berendvosmer/Tekenrobot/Hardware/Fotos/Small_Hardware_Parts.jpg

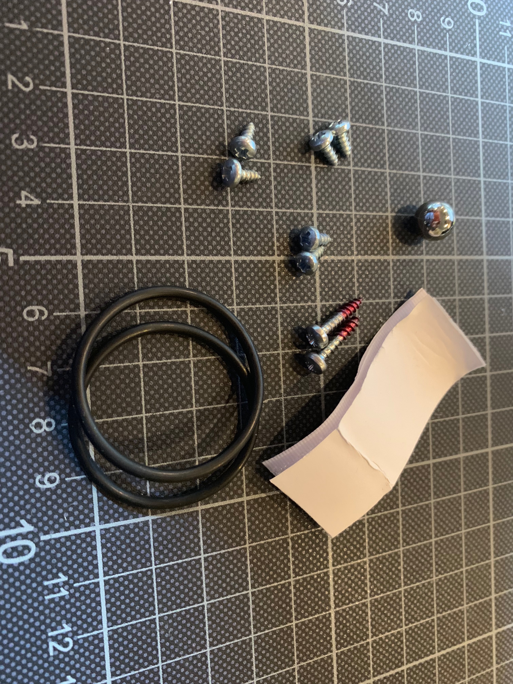
Hardware/Fotos/Small_Hardware_Parts.jpg
