berendvosmer/Tekenrobot/Documentation/Images/Arduino Create/Arduino Create.png

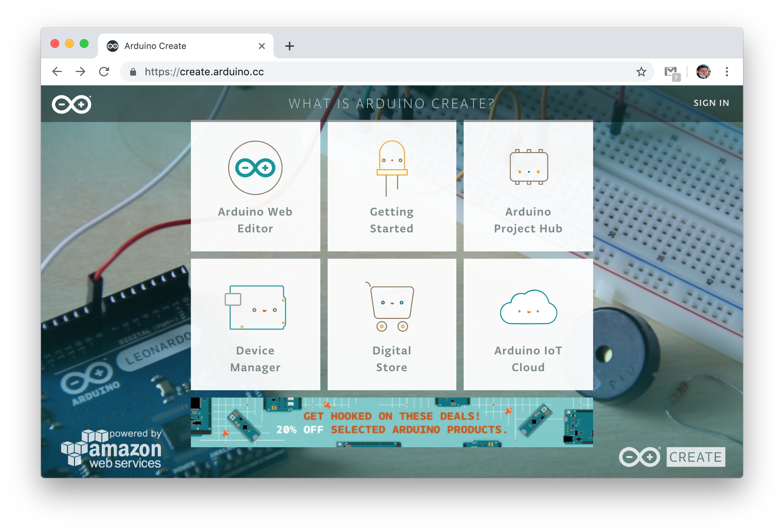
Documentation/Images/Arduino Create/Arduino Create.png
