berendvosmer/Tekenrobot/Documentation/Images/Arduino Create/Arduino Web Editor Error.png

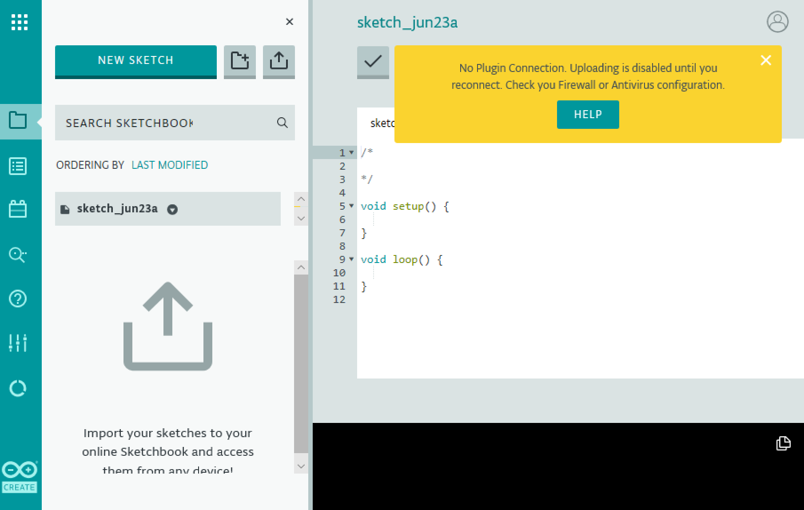
Documentation/Images/Arduino Create/Arduino Web Editor Error.png
