berendvosmer/Tekenrobot/Documentation/Images/Arduino Create/Choose port and board.png

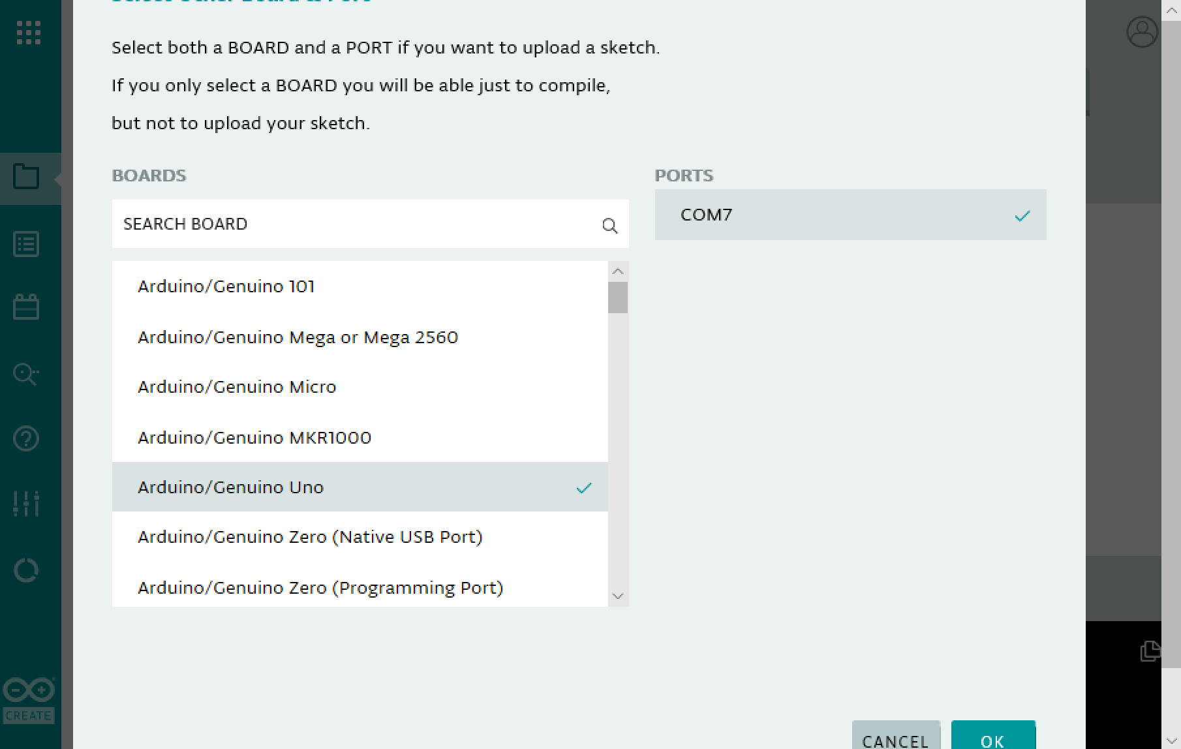
Documentation/Images/Arduino Create/Choose port and board.png
