berendvosmer/Tekenrobot/Documentation/Images/Arduino Create/Download Plug-in.png

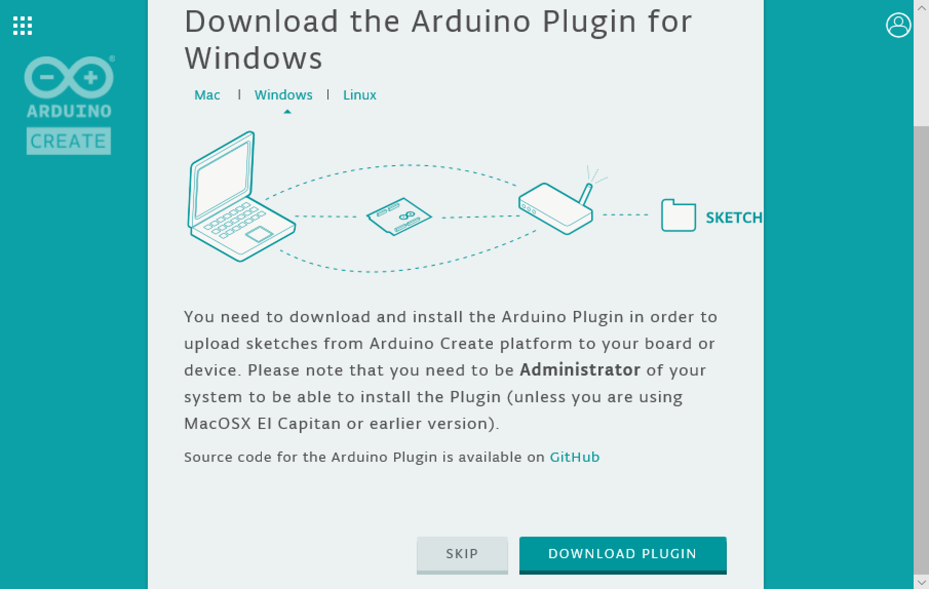
Documentation/Images/Arduino Create/Download Plug-in.png
