berendvosmer/Tekenrobot/Documentation/Images/Arduino Create/Succes.png

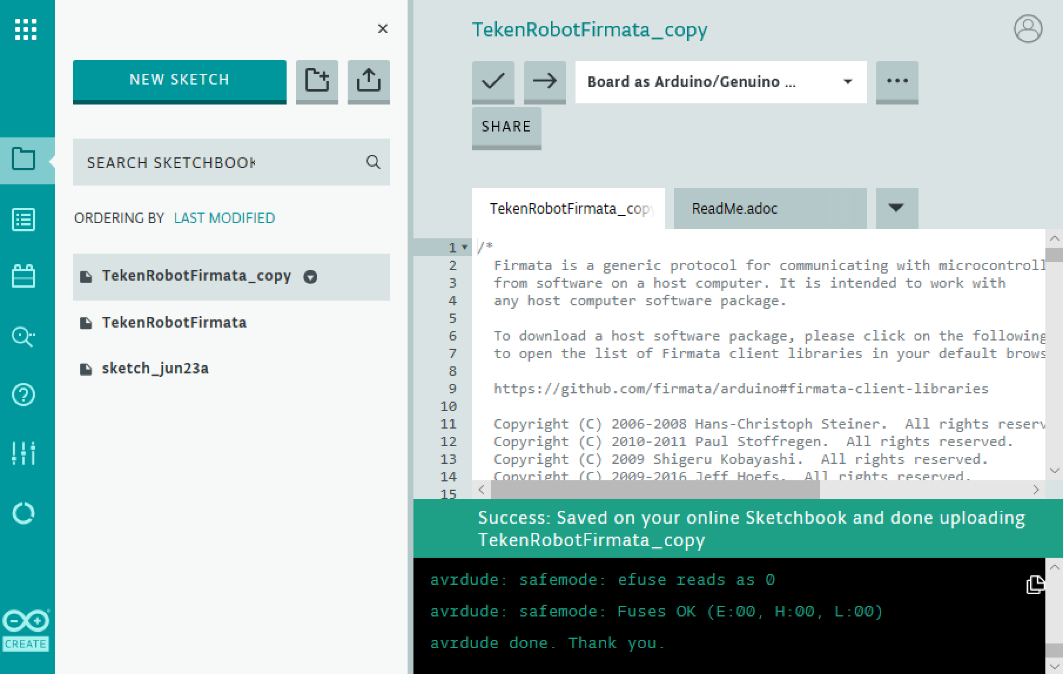
Documentation/Images/Arduino Create/Succes.png
