berendvosmer/Tekenrobot/Documentation/Images/Disconnect Bluetooth module.jpg

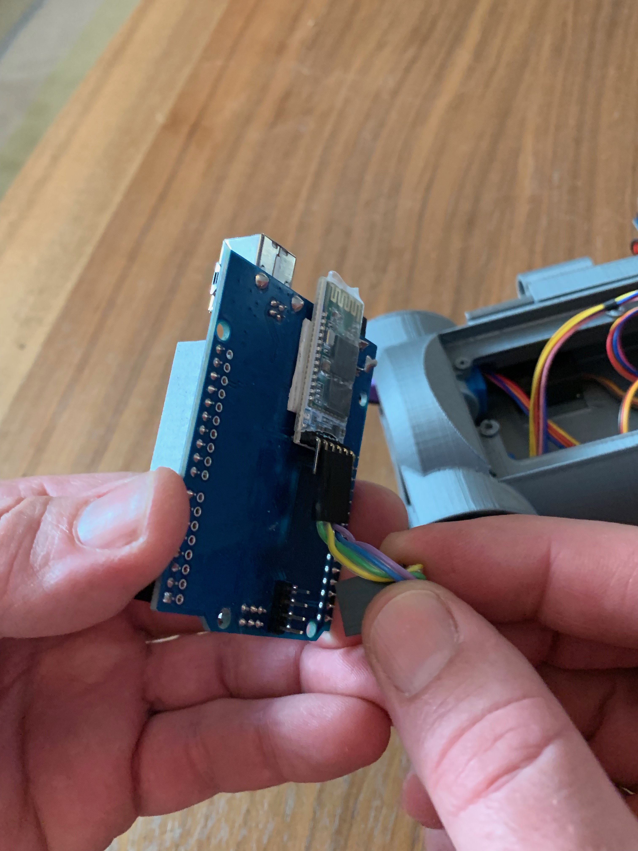
Documentation/Images/Disconnect Bluetooth module.jpg
