berendvosmer/Tekenrobot/Documentation/Images/Fold away motor shield.jpg

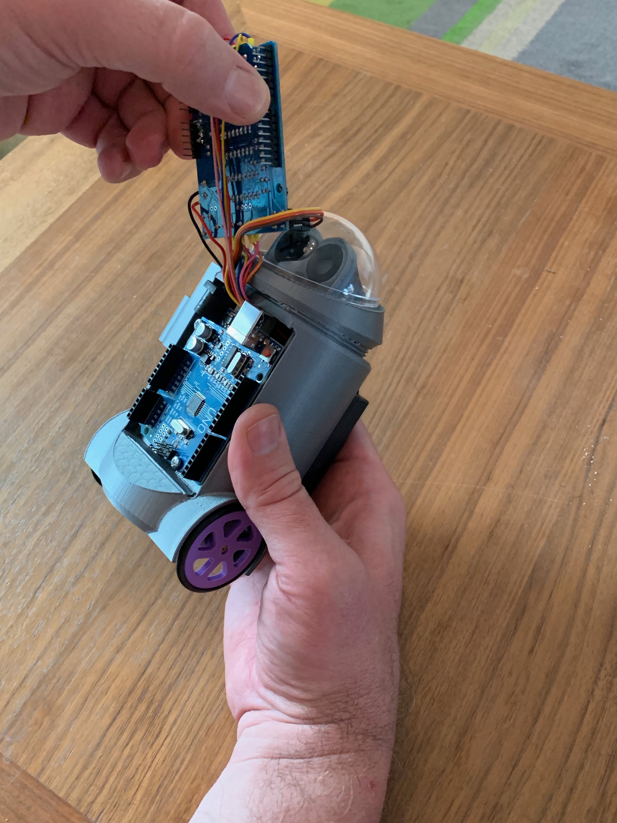
Documentation/Images/Fold away motor shield.jpg
