berendvosmer/Tekenrobot/Documentation/Images/IMG_0233.jpg

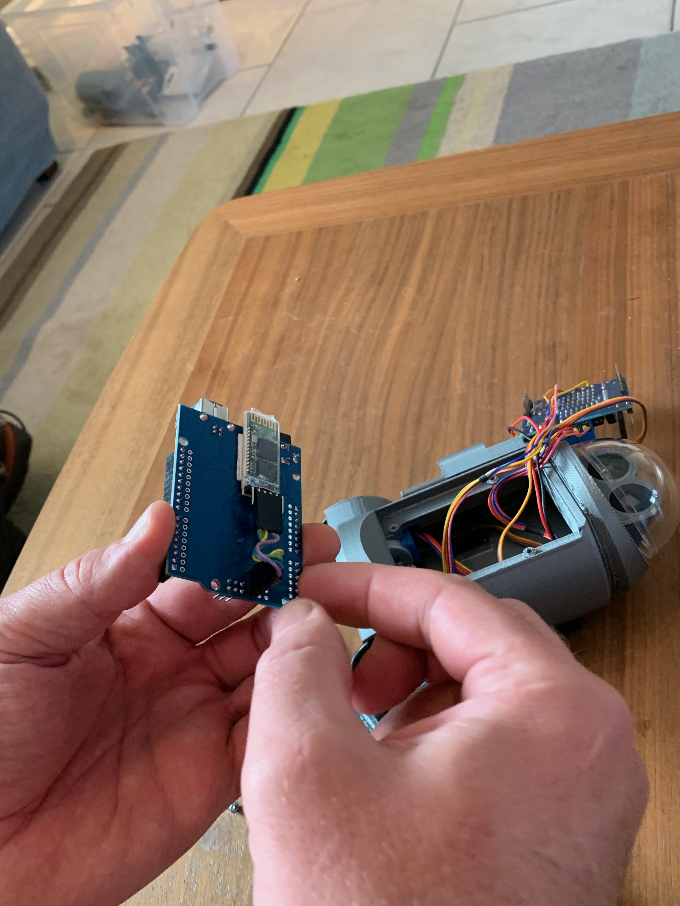
Documentation/Images/IMG_0233.jpg
