berendvosmer/Tekenrobot/Documentation/Images/IMG_0234.jpg

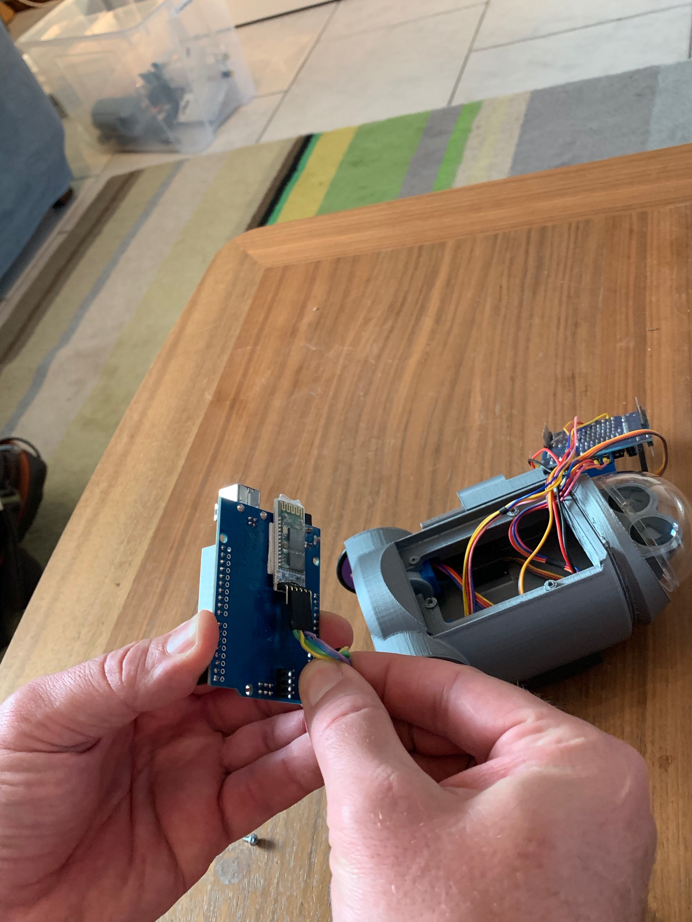
Documentation/Images/IMG_0234.jpg
