berendvosmer/Tekenrobot/Documentation/Images/IMG_0236.jpg

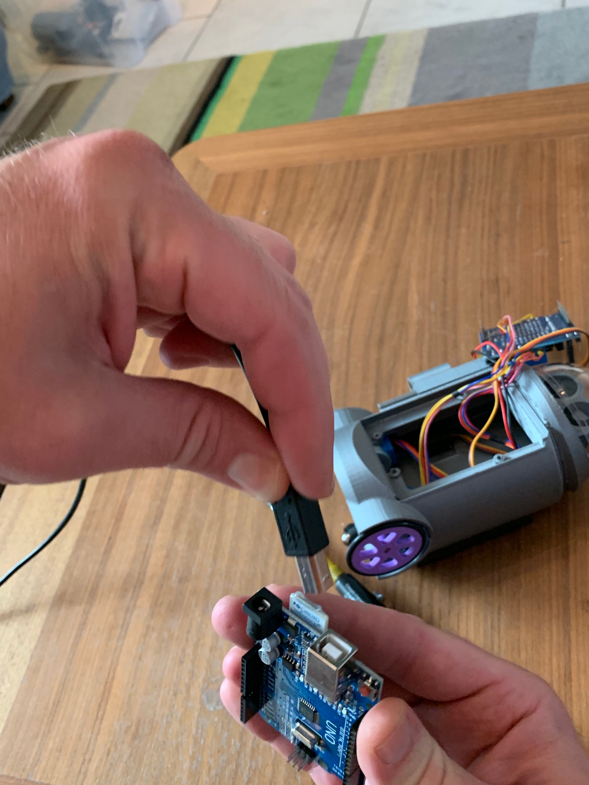
Documentation/Images/IMG_0236.jpg
