berendvosmer/Tekenrobot/Documentation/Images/IMG_0238.jpg

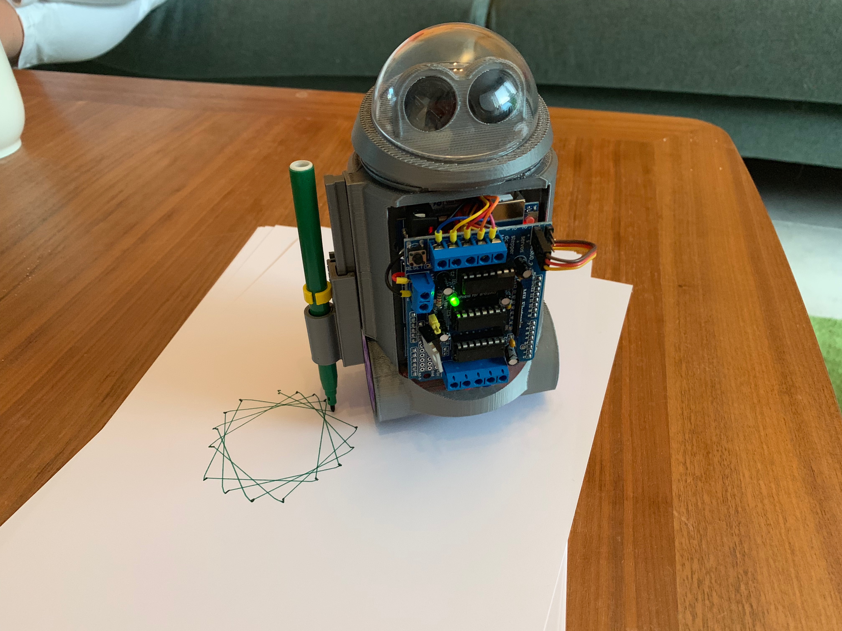
Documentation/Images/IMG_0238.jpg
