berendvosmer/Tekenrobot/Documentation/Images/Plug in USB cable.jpg

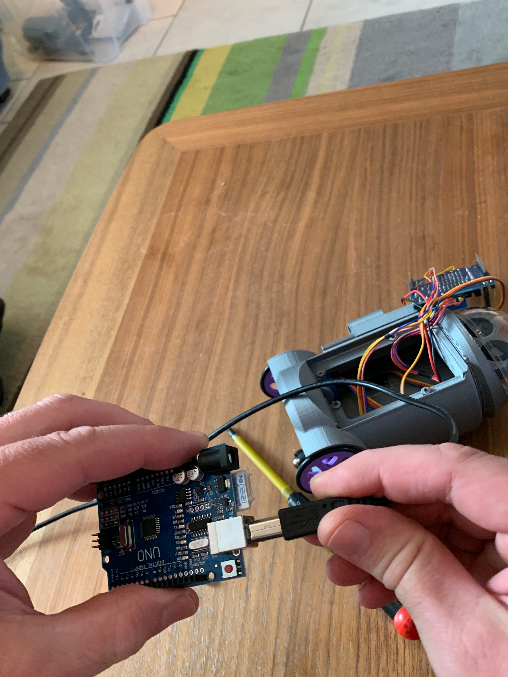
Documentation/Images/Plug in USB cable.jpg
