berendvosmer/Tekenrobot/Documentation/Images/Remove Arduino.jpg

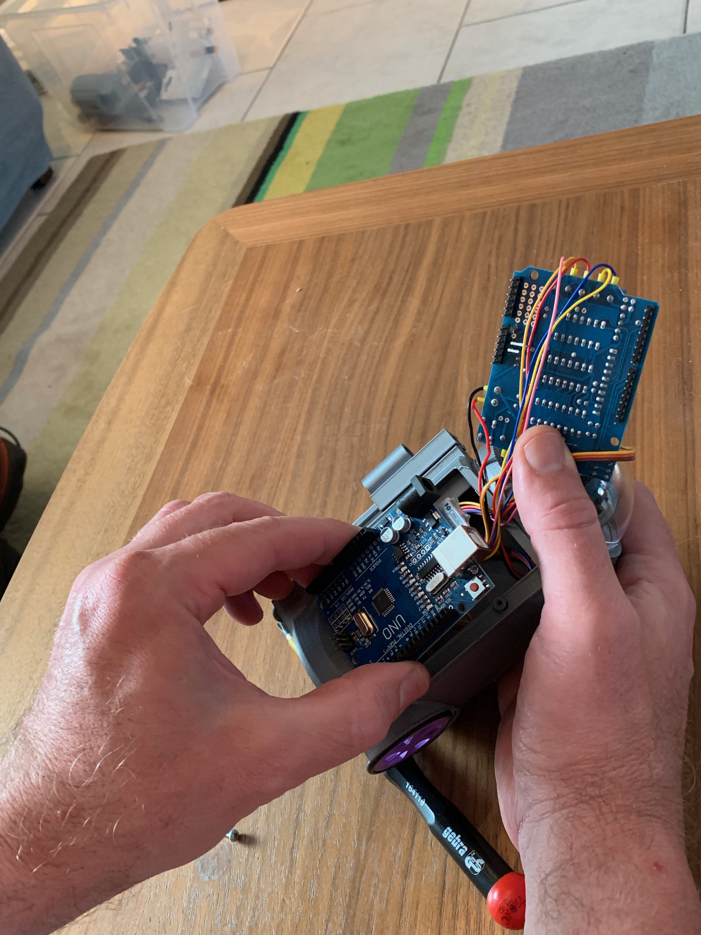
Documentation/Images/Remove Arduino.jpg
