berendvosmer/Tekenrobot/Documentation/Images/Remove Motor Shield.jpg

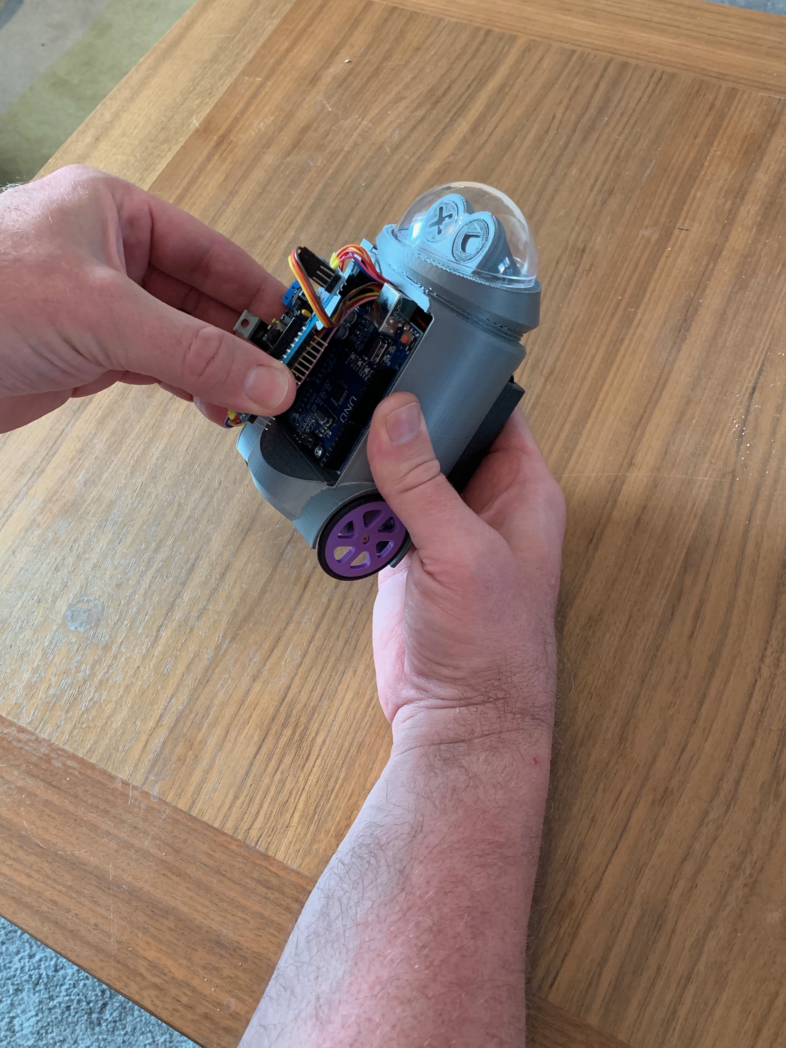
Documentation/Images/Remove Motor Shield.jpg
