berendvosmer/Tekenrobot/Documentation/Images/Snap4Arduino/Bluetooth prefs.png

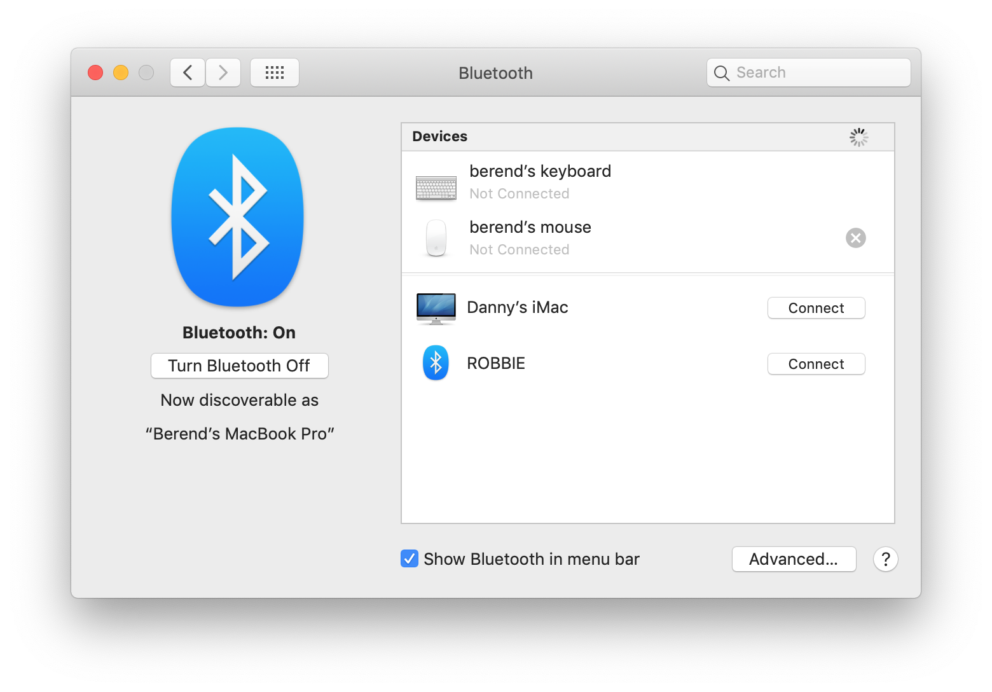
Documentation/Images/Snap4Arduino/Bluetooth prefs.png
