berendvosmer/Tekenrobot/Documentation/Images/Snap4Arduino/select port.png

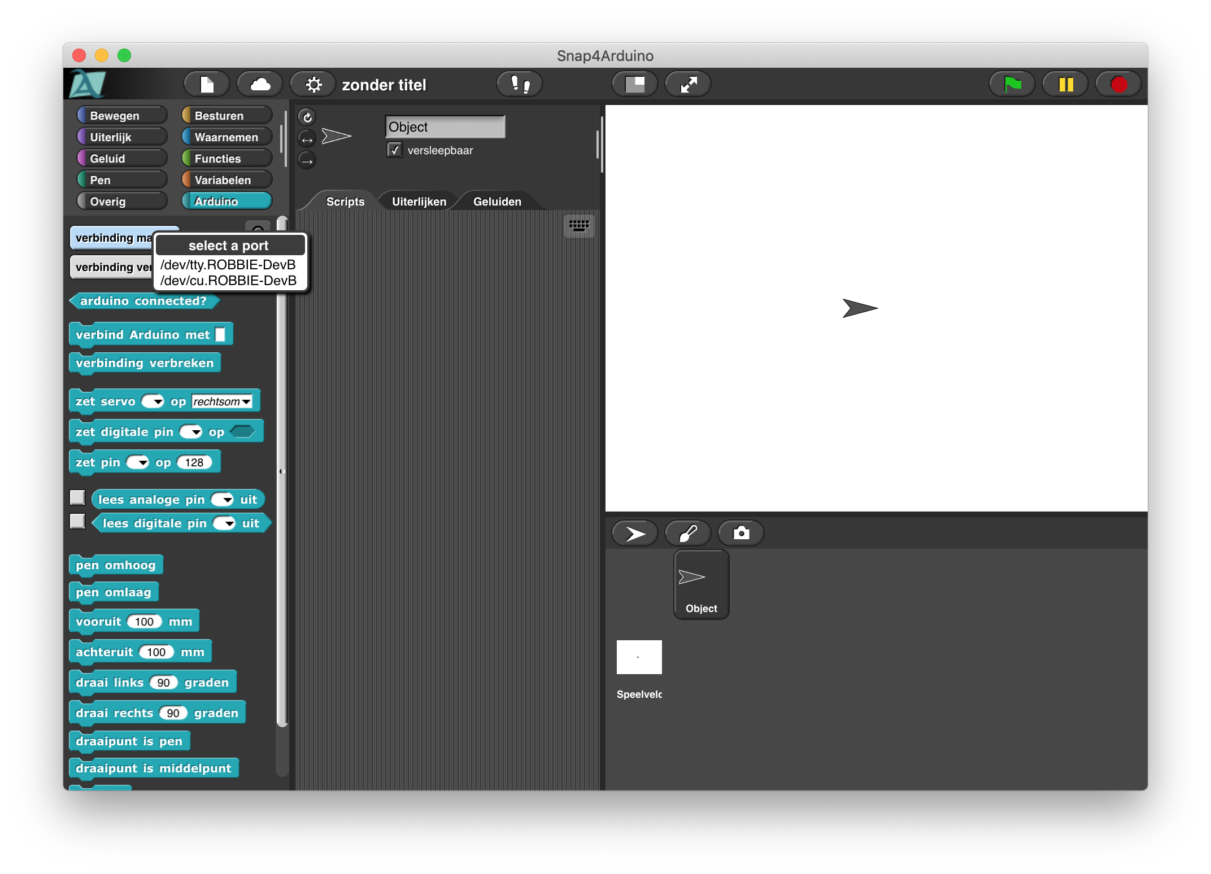
Documentation/Images/Snap4Arduino/select port.png
