berendvosmer/Tekenrobot/Documentation/Images/Unscrew Arduino 1.jpg

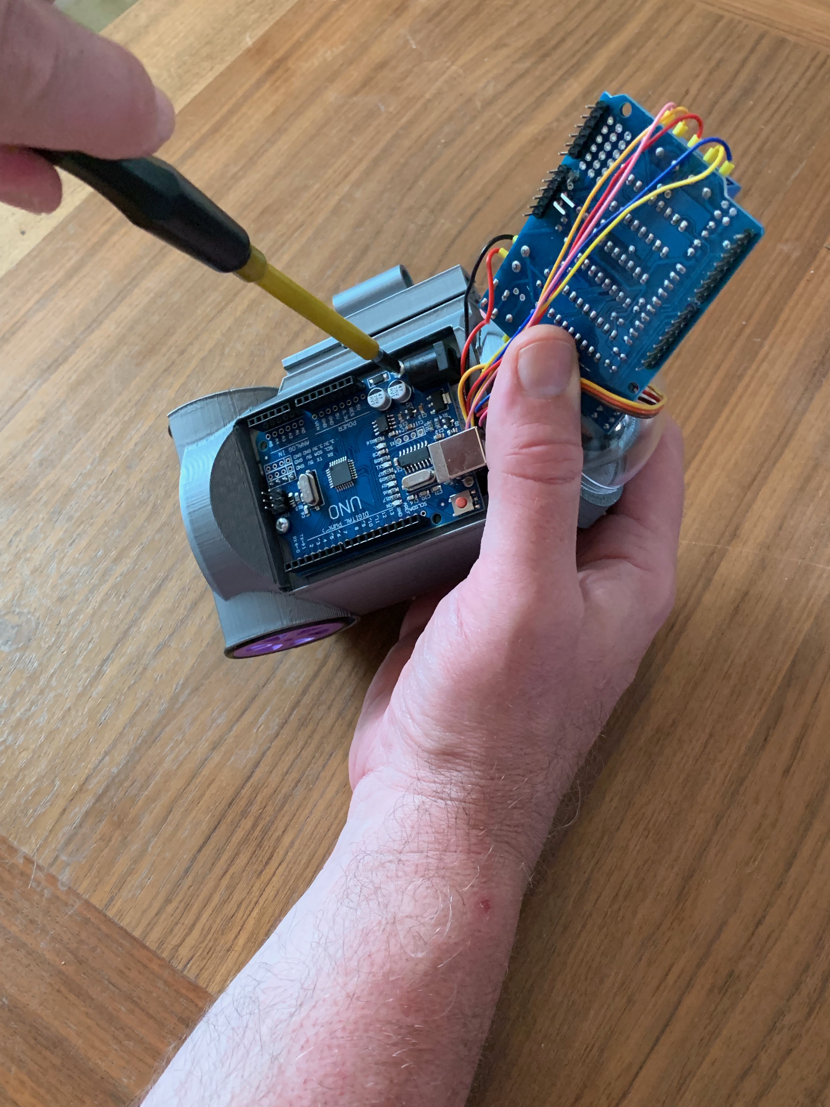
Documentation/Images/Unscrew Arduino 1.jpg
