berendvosmer/Tekenrobot/Documentation/Images/Unscrew Arduino 2.jpg

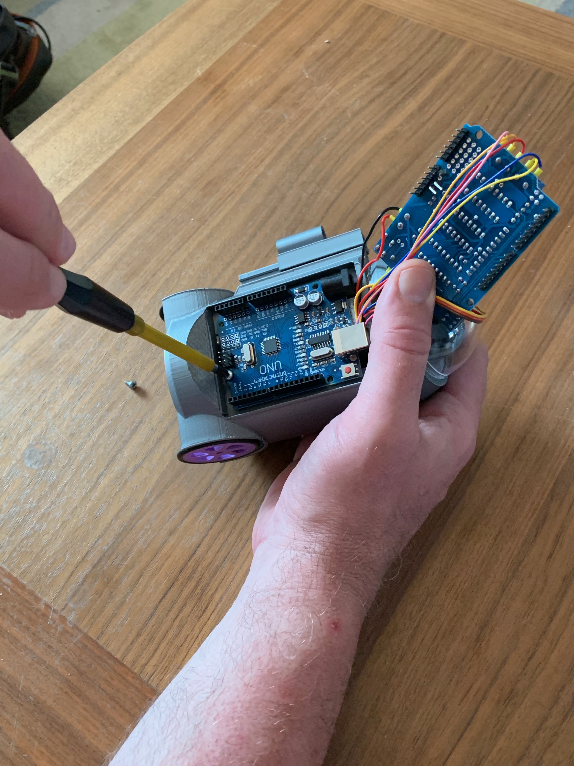
Documentation/Images/Unscrew Arduino 2.jpg
