berendvosmer/Tekenrobot/Hardware/Fotos/28BYJ-48_Stepper.jpg

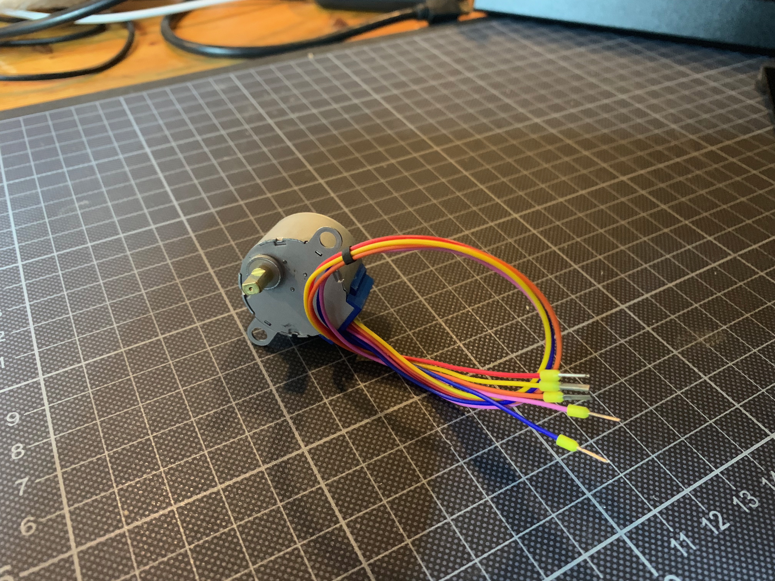
Hardware/Fotos/28BYJ-48_Stepper.jpg
