berendvosmer/Tekenrobot/Hardware/Fotos/Body.jpg

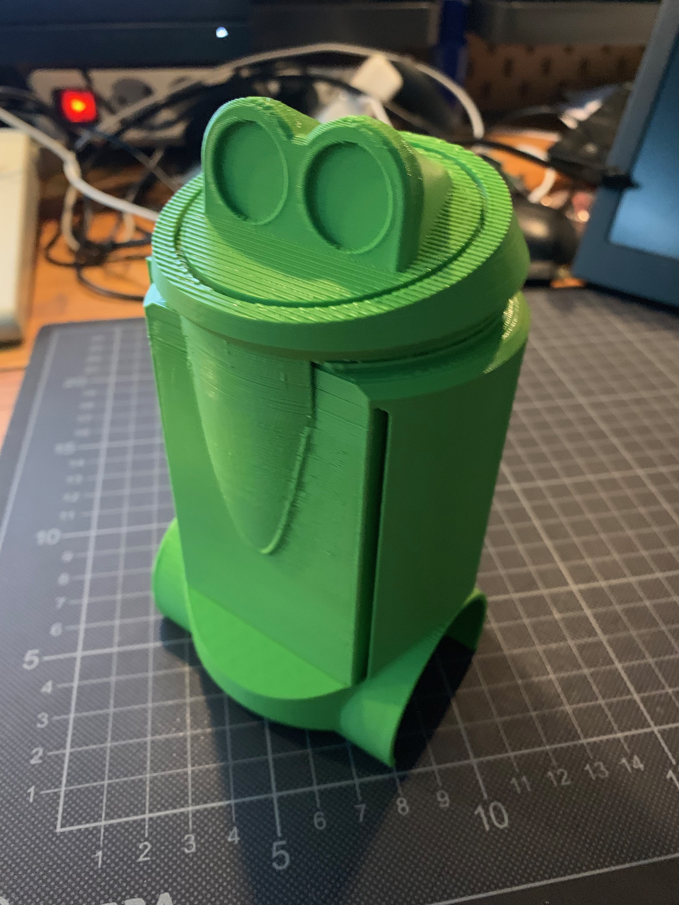
Hardware/Fotos/Body.jpg
