berendvosmer/Tekenrobot/Hardware/Fotos/Casterball_Cage.jpg

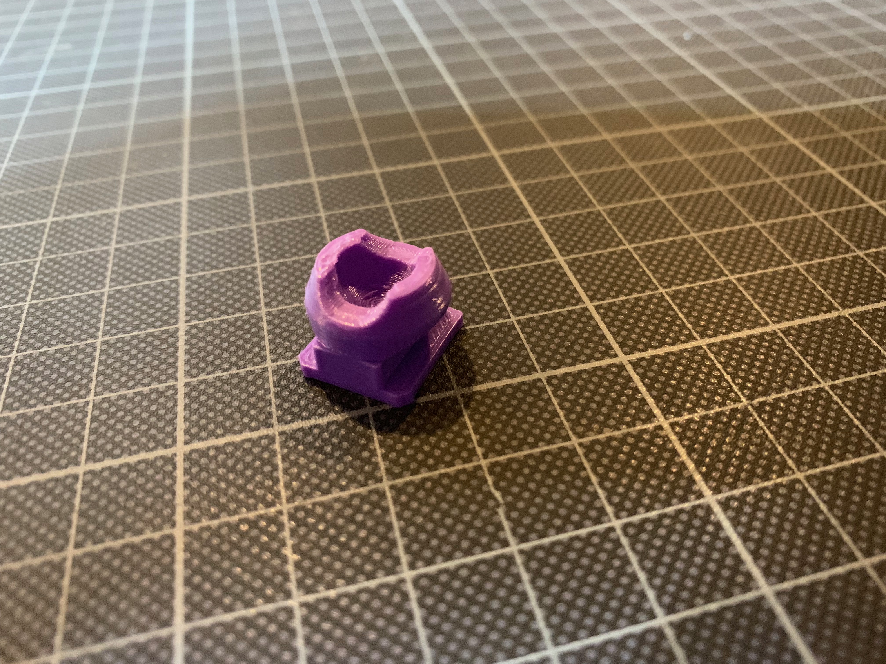
Hardware/Fotos/Casterball_Cage.jpg
