berendvosmer/Tekenrobot/Hardware/Fotos/Dome.jpg

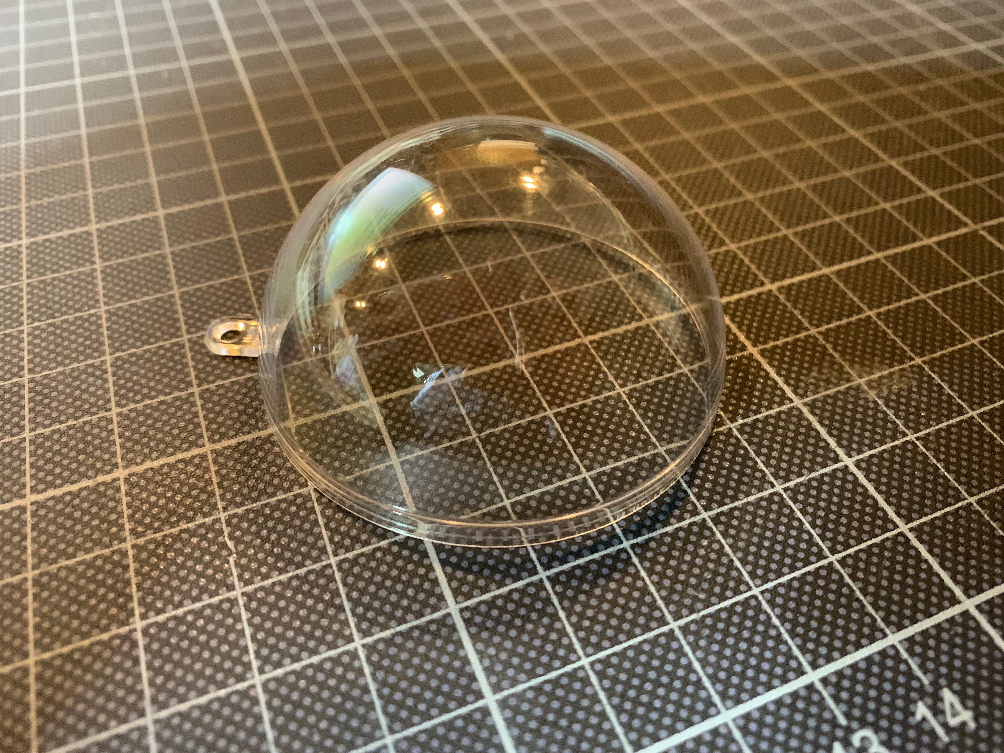
Hardware/Fotos/Dome.jpg
