berendvosmer/Tekenrobot/Hardware/Fotos/Eyes.jpg

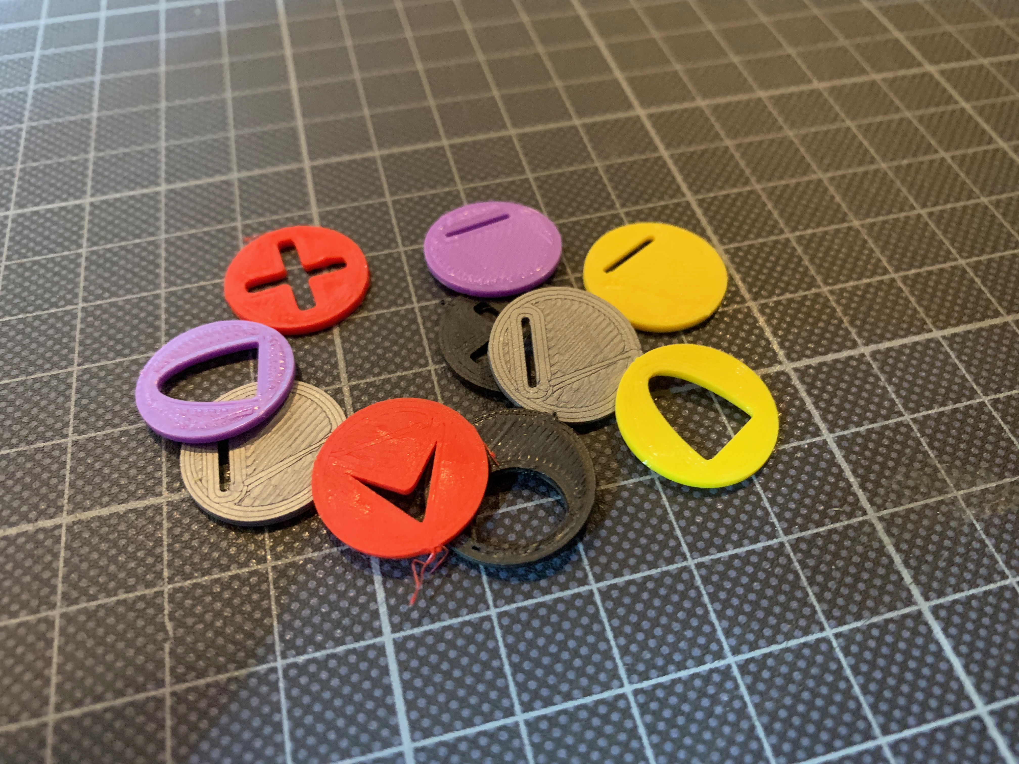
Hardware/Fotos/Eyes.jpg
