berendvosmer/Tekenrobot/Hardware/Fotos/Felt_pen.jpg

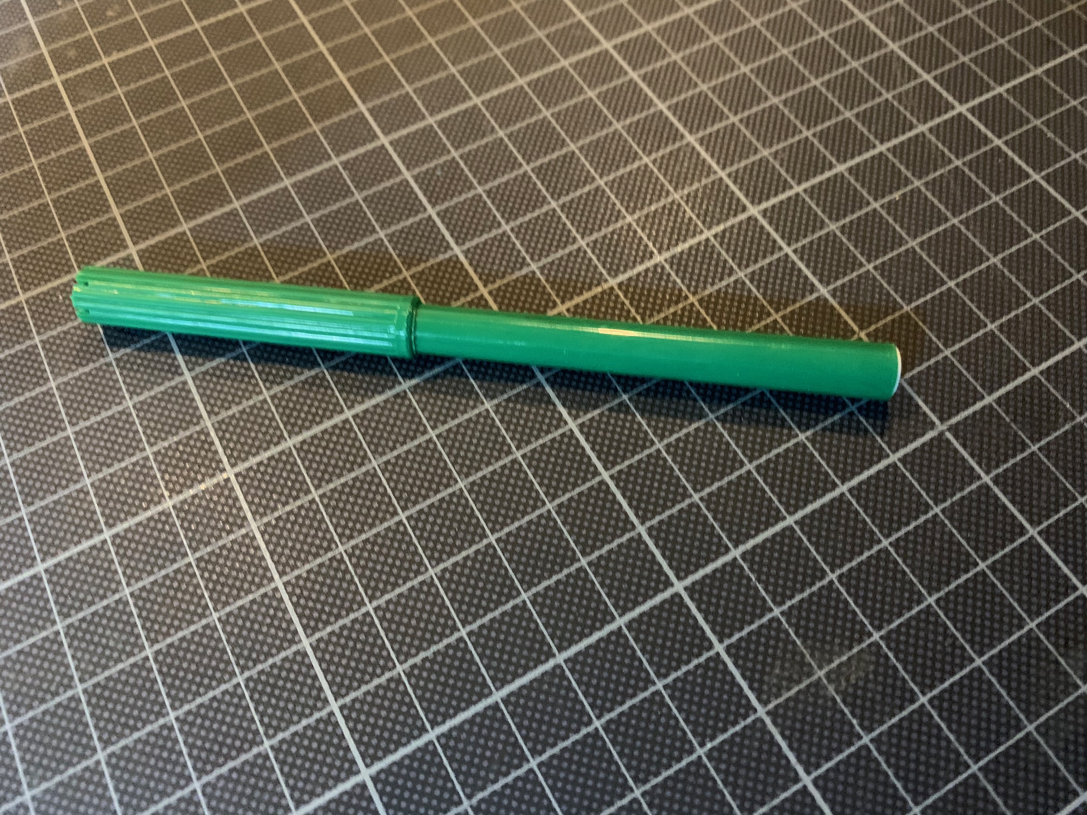
Hardware/Fotos/Felt_pen.jpg
