berendvosmer/Tekenrobot/Hardware/Fotos/Jumper_Wire.jpg

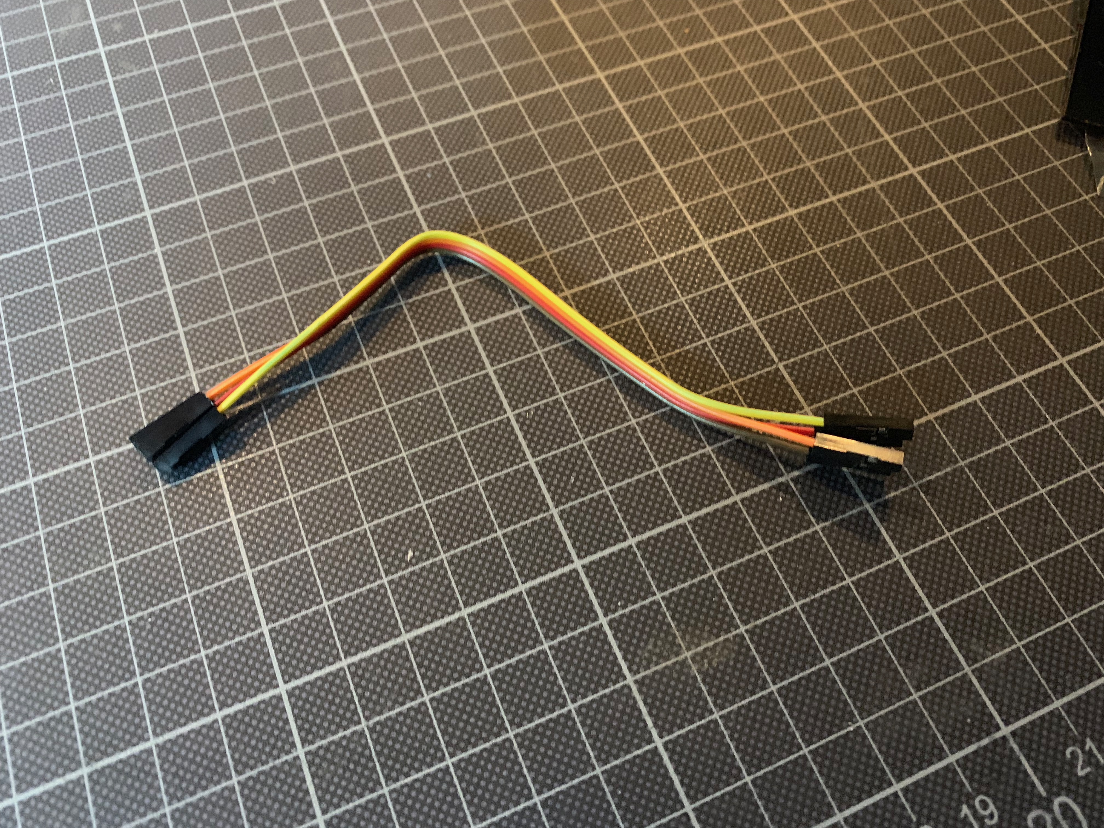
Hardware/Fotos/Jumper_Wire.jpg
