berendvosmer/Tekenrobot/Hardware/Fotos/Pinion_gear.jpg

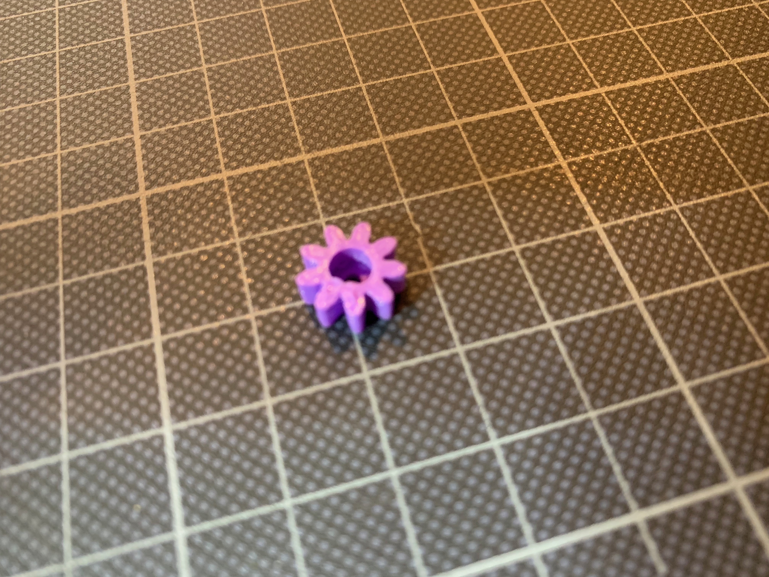
Hardware/Fotos/Pinion_gear.jpg
