berendvosmer/Tekenrobot/Hardware/Fotos/Ring.jpg

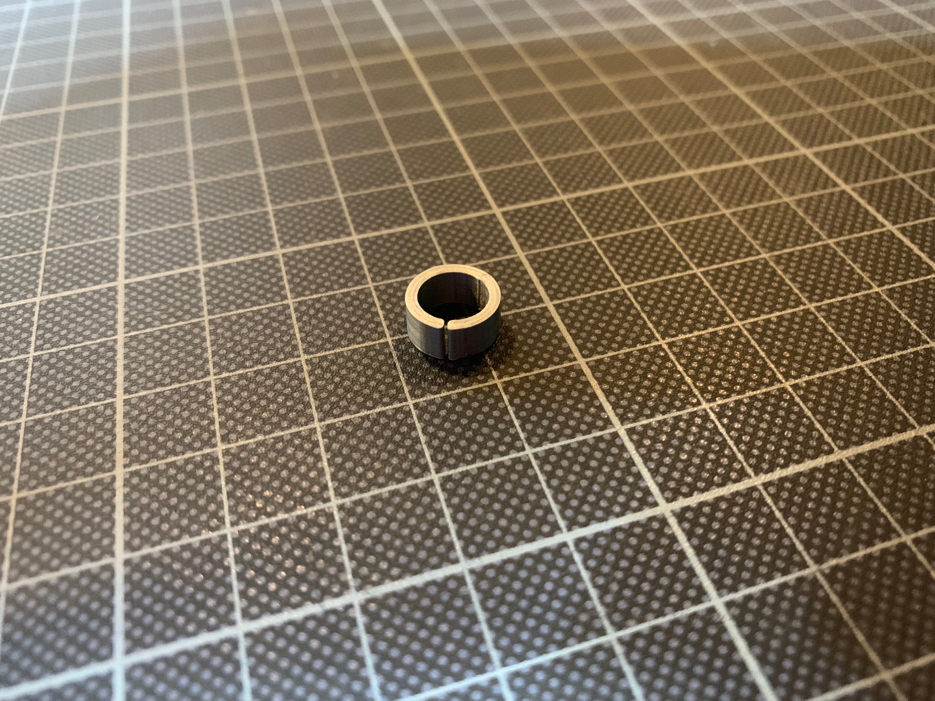
Hardware/Fotos/Ring.jpg
