berendvosmer/Tekenrobot/Hardware/Fotos/Servo_9g.jpg

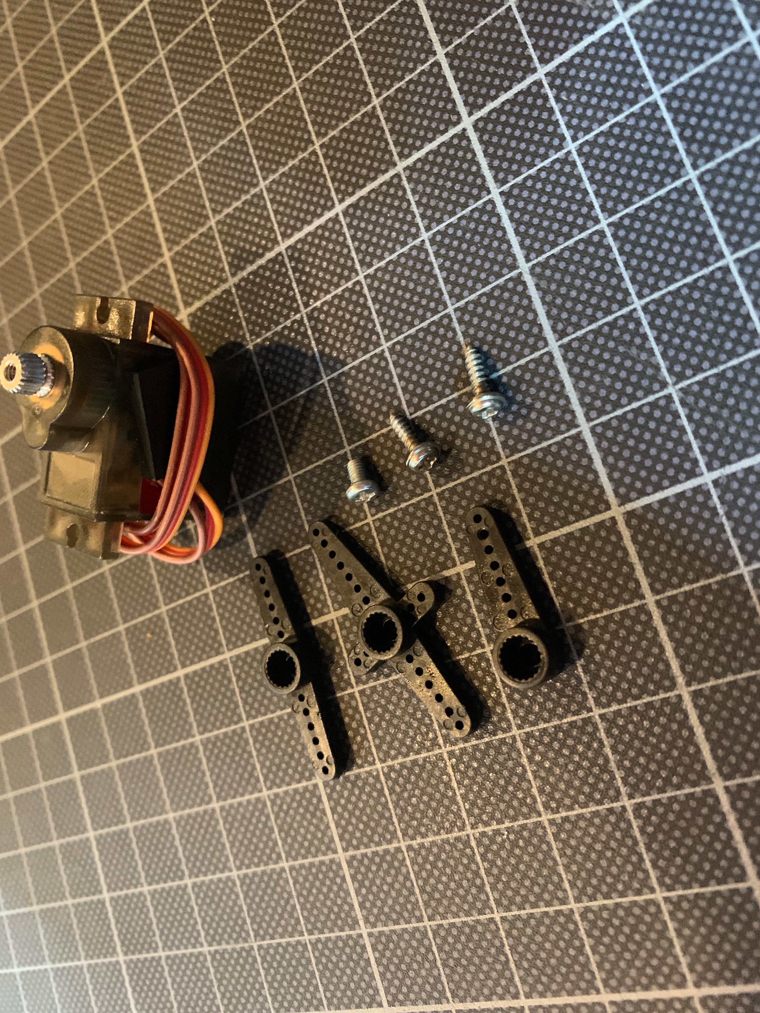
Hardware/Fotos/Servo_9g.jpg
