berendvosmer/Tekenrobot/Hardware/Fotos/Velcro.jpg

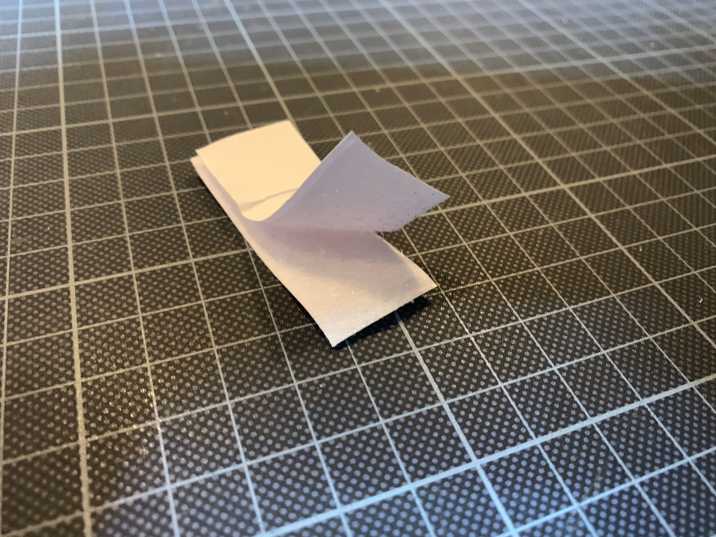
Hardware/Fotos/Velcro.jpg
