berendvosmer/Tekenrobot/Hardware/Fotos/Wheels.jpg

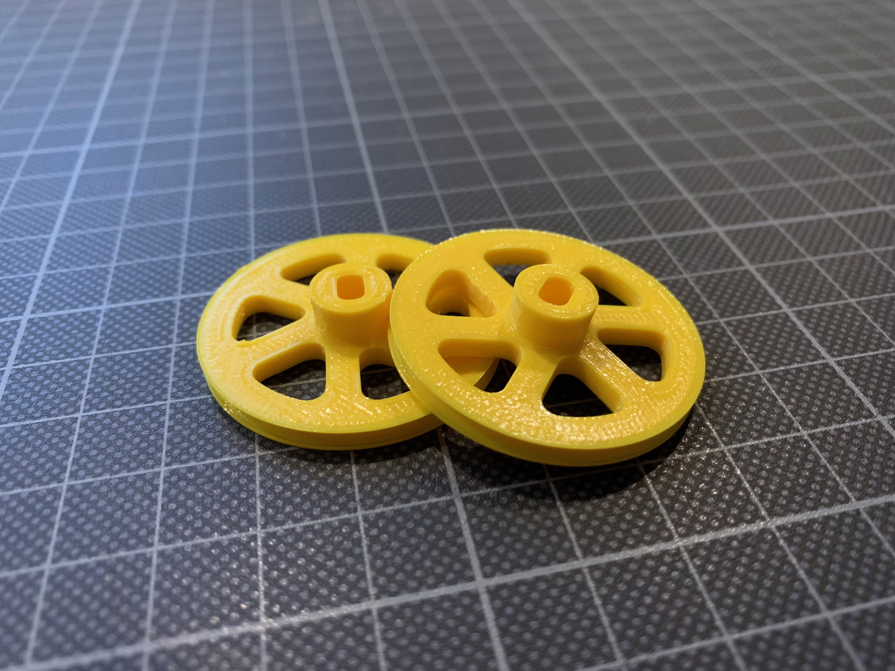
Hardware/Fotos/Wheels.jpg
