berendvosmer/Tekenrobot/Hardware/Bill of Materials.xlsx

Part # | Description | Qty | Est. Cost per item | Est. Cost | Where I got it
1 | Robot body | 1 | €4.43 | €4.43 | Printed part
2 | Right Wheel | 1 | €0.09 | €0.09 | Printed part
3 | Left Wheel | 1 | €0.09 | €0.09 | Printed part
4 | Guiderail | 1 | €0.11 | €0.11 | Printed part
5 | Guide | 1 | €0.21 | €0.21 | Printed part
6 | Ring | 1 | €0.01 | €0.01 | Printed part
7 | Casterball Cage | 1 | €0.07 | €0.07 | Printed part
8 | Pinion Gear | 1 | €0.01 | €0.01 | Printed part
9 | Eyes | 2 | €0.02 | €0.04 | Printed part
10 | Dome (half of transparent decorative ball) 60mm | 1 | €0.50 | €0.50 | any hobby shop
11 | Felt pen (9mm diam.) | 1 | €0.05 | €0.05 | hema.nl
12 | Piece of stick-on Velcro (both sides) | 1 | €0.10 | €0.10 | DIY shop
13 | 28BYJ-48 5v Stepper motor | 2 | €1.22 | €2.44 | AliExpress
14 | 4-lead female-female jumper wire | 1 | €0.02 | €0.02 | AliExpress
15 | Hobby servo metal-gear 9g | 1 | €1.77 | €1.77 | AliExpress
16 | Arduino Uno (with serial breakout) | 1 | €2.12 | €2.12 | AliExpress
17 | Adafruit AF_Motor v1 shield | 1 | €0.95 | €0.95 | AliExpress
18 | Bluetooth module (HC-05 or JDY-30) | 1 | €1.40 | €1.40 | AliExpress
19 | O-ring 3.1mm x 37mm | 2 | €0.12 | €0.24 | AliExpress
20 | raised head philips screw 2.9mm x 6.5 mm | 6 | €0.07 | €0.42 | Local electronics store
21 | raised head philips screw 2.9mm x 16 mm | 2 | €0.07 | €0.14 | Local electronics store
22 | Bearing Ball 9mm | 1 | €0.07 | €0.07 | AliExpress
23 | Battery holder 4x AA with switch | 1 | €0.24 | €0.24 | AliExpress
24 | AA Alkaline Battery | 4 | €0.50 | €2.00 | AliExpress
25 | Voltage regulator ultra-low drop TS2940 | 1 | €1.15 | €1.15 | Local electronics store
26 | pin strip, straight 4x1 pin | 1 | €0.00 | €0.00 | included with Arduino
27 | Ferrule 0.25mm2 x 6mm (isolated) | 12 | €0.04 | €0.48 | Local electronics store
 |  |  | Total | €19.15
