berendvosmer/Tekenrobot/Hardware/STLs/Eyes/cross.stl

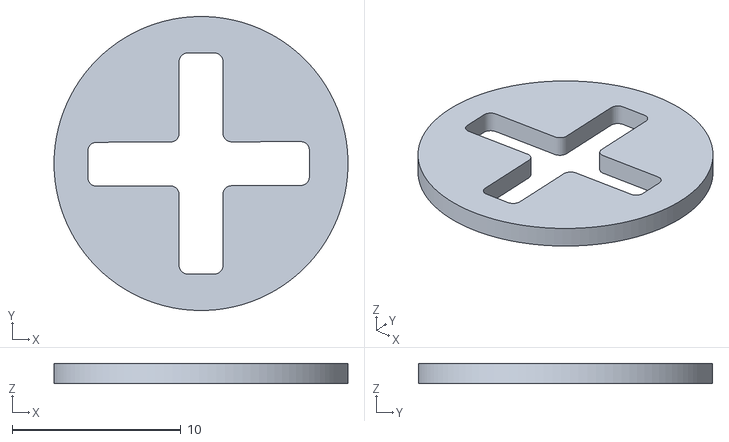
[picture p48: CAD file, 2019-06-23]
Hardware/STLs/Eyes/cross.stl
17.4 x 17.4 x 1.20
