berendvosmer/Tekenrobot/Hardware/STLs/Ring.stl

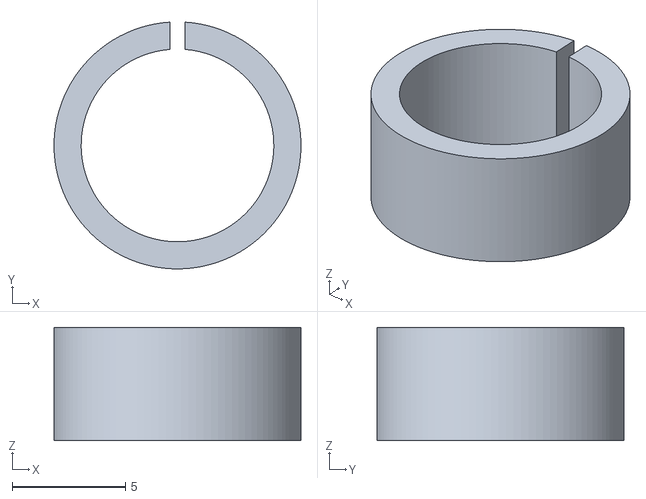
[picture p49: CAD file, 2019-06-23]
Hardware/STLs/Ring.stl
10.9 x 10.9 x 5.00
