berendvosmer/Tekenrobot/Hardware/STLs/Caster ball cage.stl

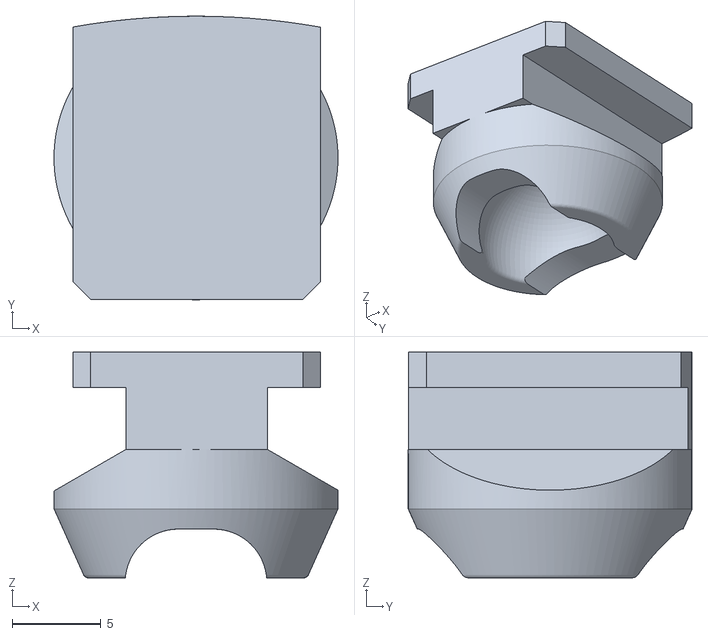
[picture p50: CAD file, 2019-06-23]
Hardware/STLs/Caster ball cage.stl
16.0 x 16.0 x 12.8
