berendvosmer/Tekenrobot/Hardware/STLs/Eyes/cheery.stl

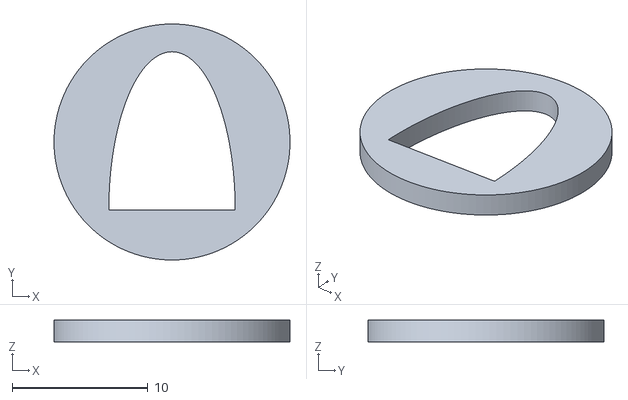
[picture p51: CAD file, 2019-06-23]
Hardware/STLs/Eyes/cheery.stl
17.4 x 17.4 x 1.60
