berendvosmer/Tekenrobot/Hardware/STLs/Eyes/squint.stl

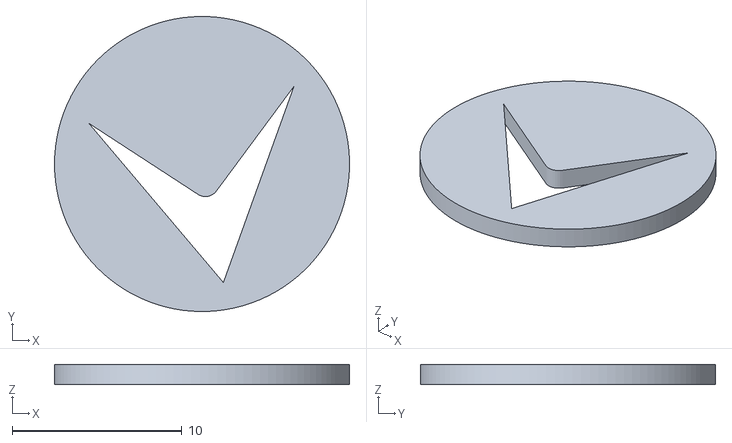
[picture p52: CAD file, 2019-06-23]
Hardware/STLs/Eyes/squint.stl
17.4 x 17.4 x 1.20
