berendvosmer/Tekenrobot/Hardware/STLs/Guiderail.stl

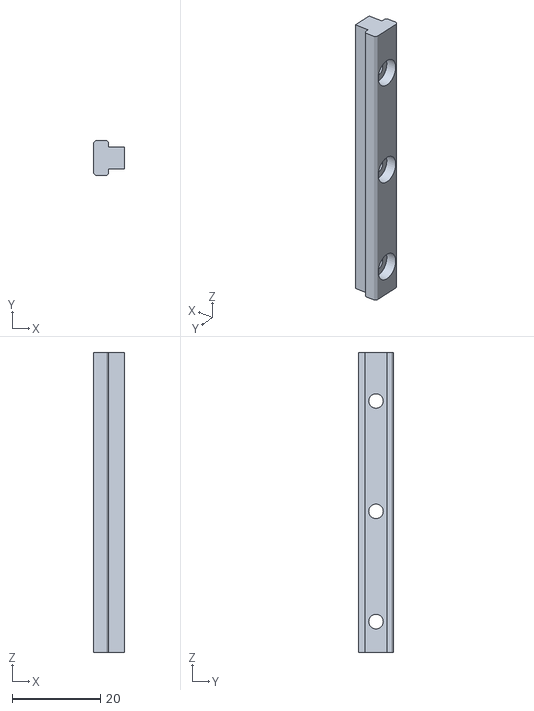
[picture p53: CAD file, 2019-06-23]
Hardware/STLs/Guiderail.stl
7.00 x 8.00 x 68.0
