berendvosmer/Tekenrobot/Hardware/STLs/Eyes/stripe.stl

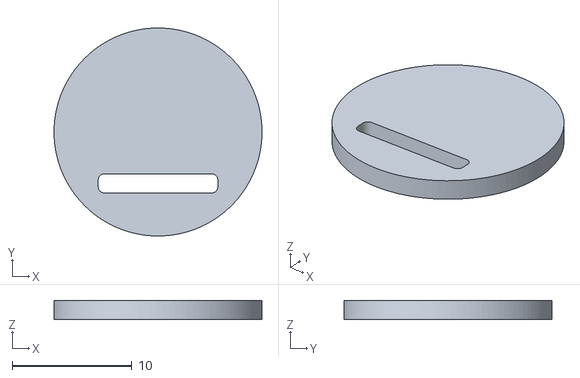
[picture p54: CAD file, 2019-06-23]
Hardware/STLs/Eyes/stripe.stl
17.4 x 17.4 x 1.60
