berendvosmer/Tekenrobot/Hardware/STLs/Right wheel.stl

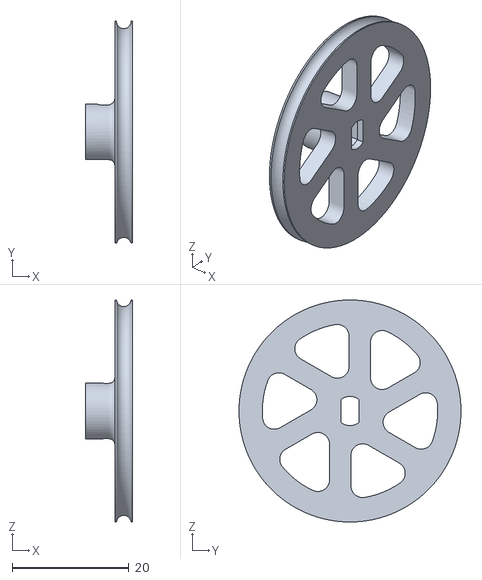
[picture p55: CAD file, 2019-06-23]
Hardware/STLs/Right wheel.stl
8.00 x 38.0 x 38.0
