berendvosmer/Tekenrobot/Hardware/STLs/Eyes/updown.stl

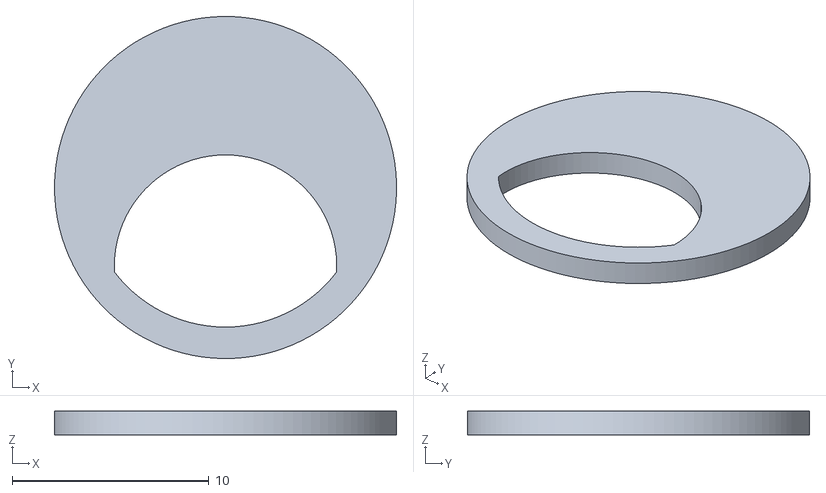
[picture p56: CAD file, 2019-06-23]
Hardware/STLs/Eyes/updown.stl
17.4 x 17.4 x 1.20
