berendvosmer/Tekenrobot/Hardware/STLs/Base.stl

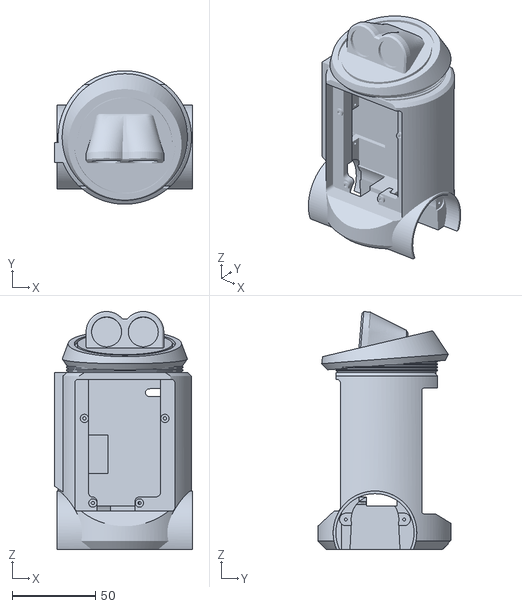
[picture p57: CAD file, 2019-06-23]
Hardware/STLs/Base.stl
82.8 x 80.0 x 142.7
