berendvosmer/Tekenrobot/Hardware/STLs/Eyes/brow.stl

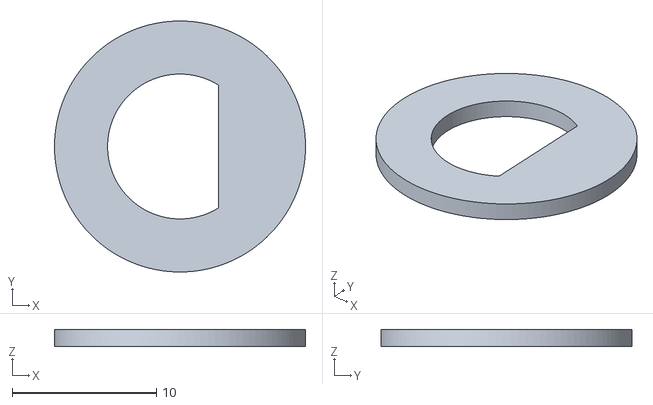
[picture p58: CAD file, 2019-06-23]
Hardware/STLs/Eyes/brow.stl
17.4 x 17.4 x 1.20
