berendvosmer/Tekenrobot/Hardware/STLs/Guide.stl

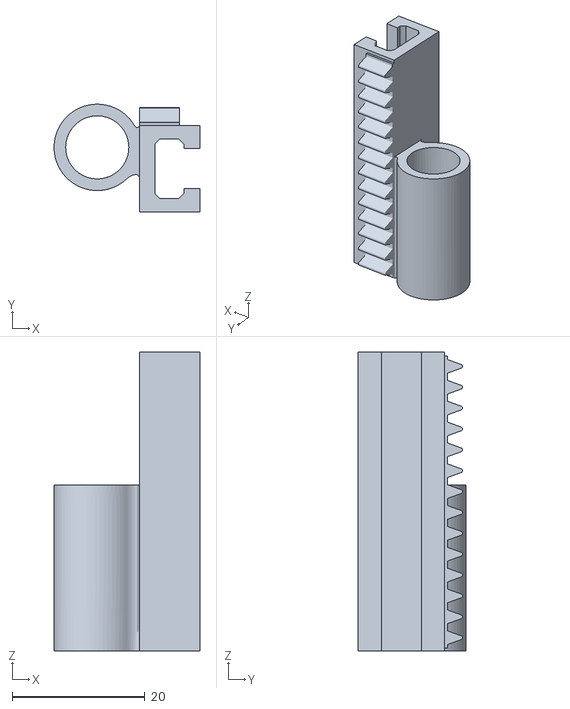
[picture p59: CAD file, 2019-06-23]
Hardware/STLs/Guide.stl
22.0 x 16.2 x 45.0
