berendvosmer/Tekenrobot/Hardware/STLs/Pinion Gear.stl

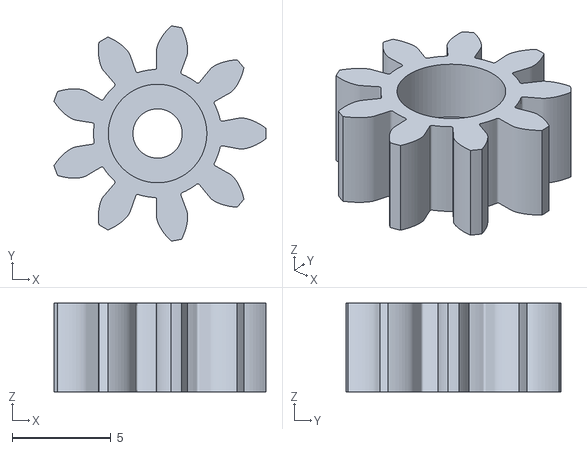
[picture p60: CAD file, 2019-06-23]
Hardware/STLs/Pinion Gear.stl
10.8 x 10.9 x 4.50
