berendvosmer/Tekenrobot/Hardware/STLs/Base with support.stl

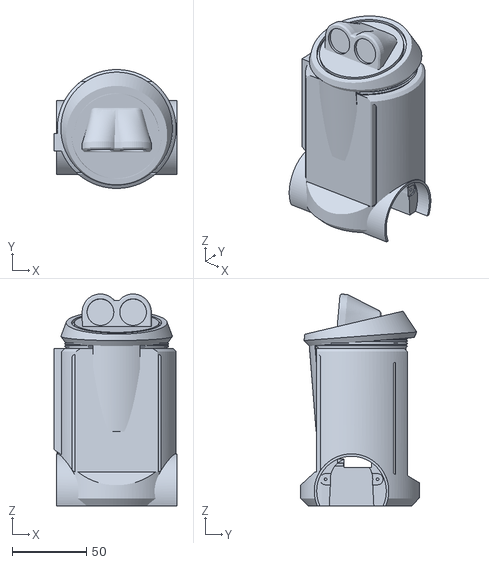
[picture p61: CAD file, 2019-06-23]
Hardware/STLs/Base with support.stl
82.8 x 80.0 x 142.7
