berendvosmer/Tekenrobot/(list of files, cad)

Other CAD files:
Hardware/STLs/Left wheel.stl
