berendvosmer/Tekenrobot/Documentation/Images/Arduino Create/Reinstall Plug-in.png

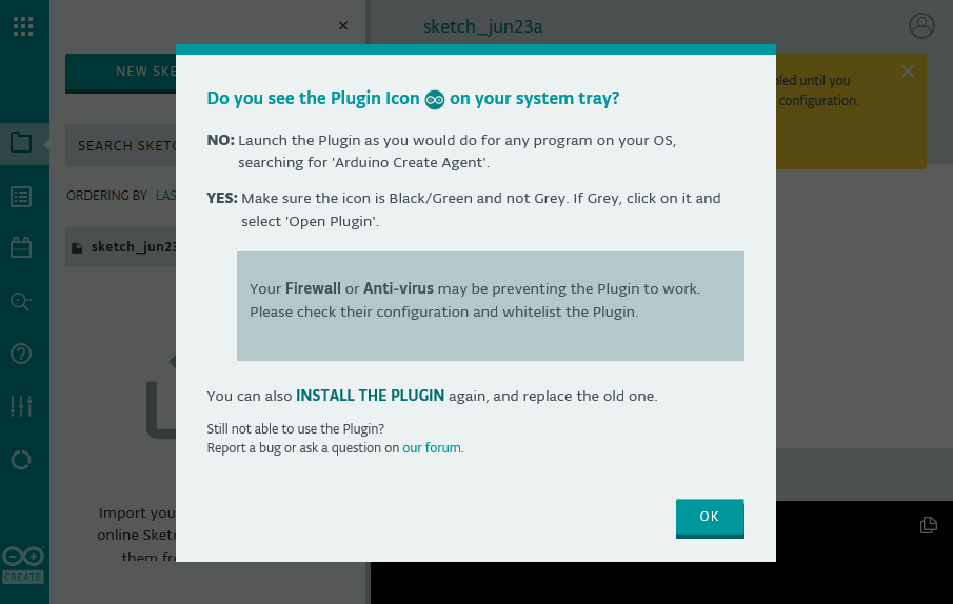
Documentation/Images/Arduino Create/Reinstall Plug-in.png
