berendvosmer/Tekenrobot/Hardware/Fotos/Guide.jpg

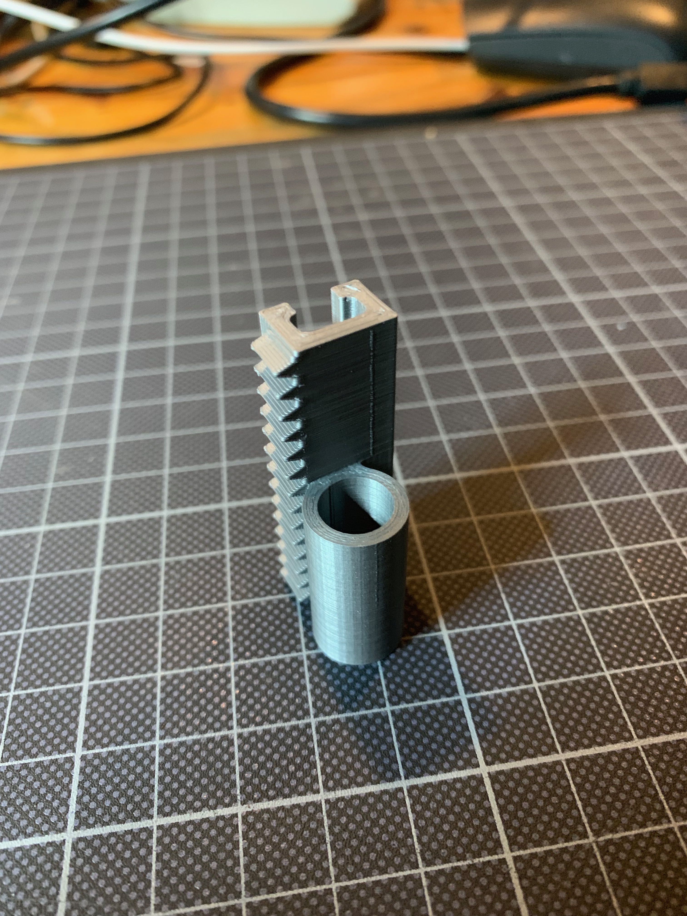
Hardware/Fotos/Guide.jpg
