berendvosmer/Tekenrobot/Hardware/Fotos/Guiderail.jpg

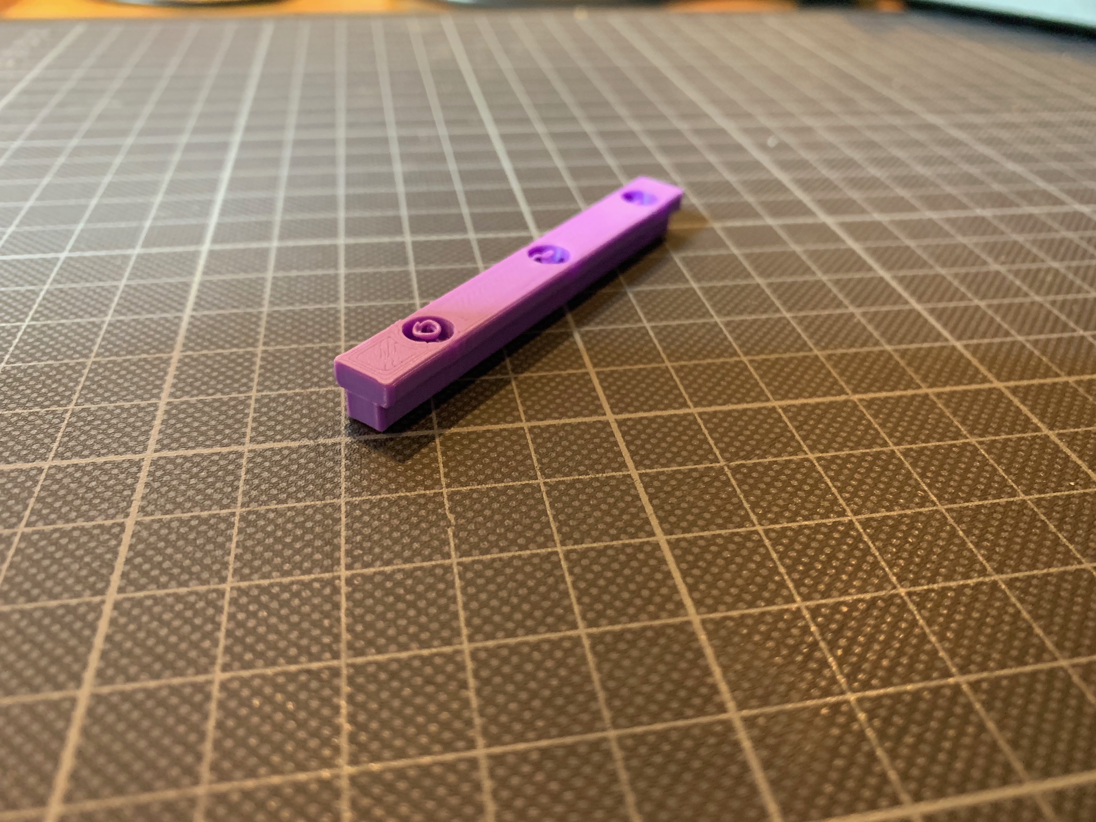
Hardware/Fotos/Guiderail.jpg
