berendvosmer/Tekenrobot/(threads)

Thread 2 (2019-06-22):

Notify Snap4Arduino code with sysex message from Arduino

berendvosmer, 2019-06-22:
Arduino sends 0x08, 0x01 sysex message when steppers complete their moves.

I have not yet found a way to incorporate this mechanisme in my Snap4Arduino code blocks. Now I just inelegantly wait a proportionate amount of time to the distance travelled.
