berendvosmer/Tekenrobot/(commit log)

2019-06-08 Eerste upload
    [Tekenrobot.xml]
2019-06-16 Fixed serial buffer overflow issue.
    Now Arduino sends 0x08,0x01 sysex message when finished (hopefully).
    [TekenRobotFirmata.ino]
2019-06-16 Arduino code actually sends the relevant message when steppers reach their goal.
    javascript in Snap4Arduino/testje.js works in node.js.
    [TekenRobotFirmata.ino]
2019-06-17 Clean up and revert to just waiting e set amount of time
    [Tekenrobot.xml]
2019-06-21 Updated documentation.
    Changes to Arduino/TekenRobotFirmata/TekenRobotFirmata.ino are just changes to wheel diameter.
2019-06-22 Solved a bug that caused the robot to go double the distance (both on straight moves and turns)
    [TekenRobotFirmata.ino]
2019-06-22 Added Hardware
    [Bill of Materials.xlsx]
2019-06-23 Added parts (fotos and STL-files)
    [Base with support.stl, Base.stl, Bill of Materials.xlsx, Caster ball cage.stl, Guide.stl, Guiderail.stl, Left wheel.stl, Pinion Gear.stl]
2019-06-23 Moved Eyes STL-files
    [brow.stl, cheery.stl, cross.stl, squint.stl, stripe.stl, updown.stl]
2019-06-23 Create 3D-Print settings
2019-06-23 Added Arduino Create instructions
2019-06-26 Corrected BOM
    [Bill of Materials.xlsx]
