berendvosmer/Tekenrobot/Hardware/Fotos/AF_Motor_Shield_v1.jpg

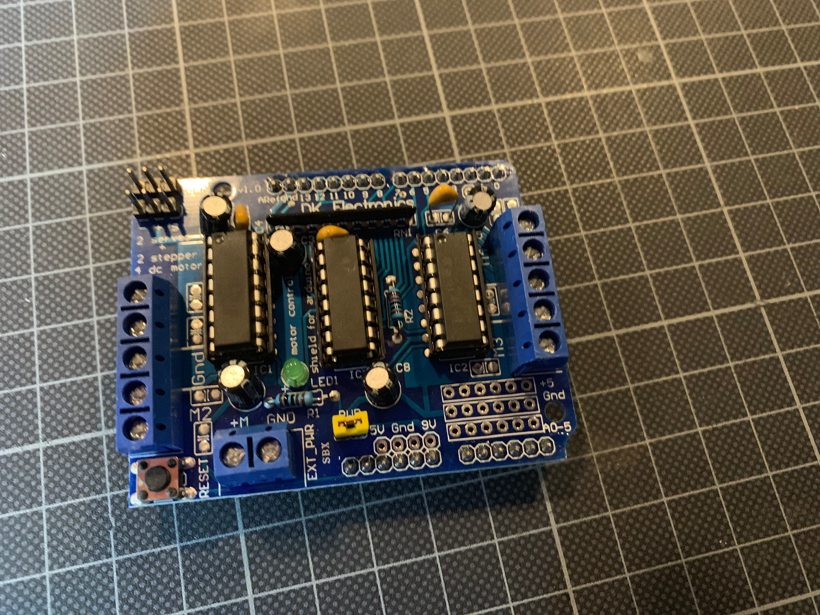
Hardware/Fotos/AF_Motor_Shield_v1.jpg
