berendvosmer/Tekenrobot/Hardware/Fotos/Arduino UNO.jpg

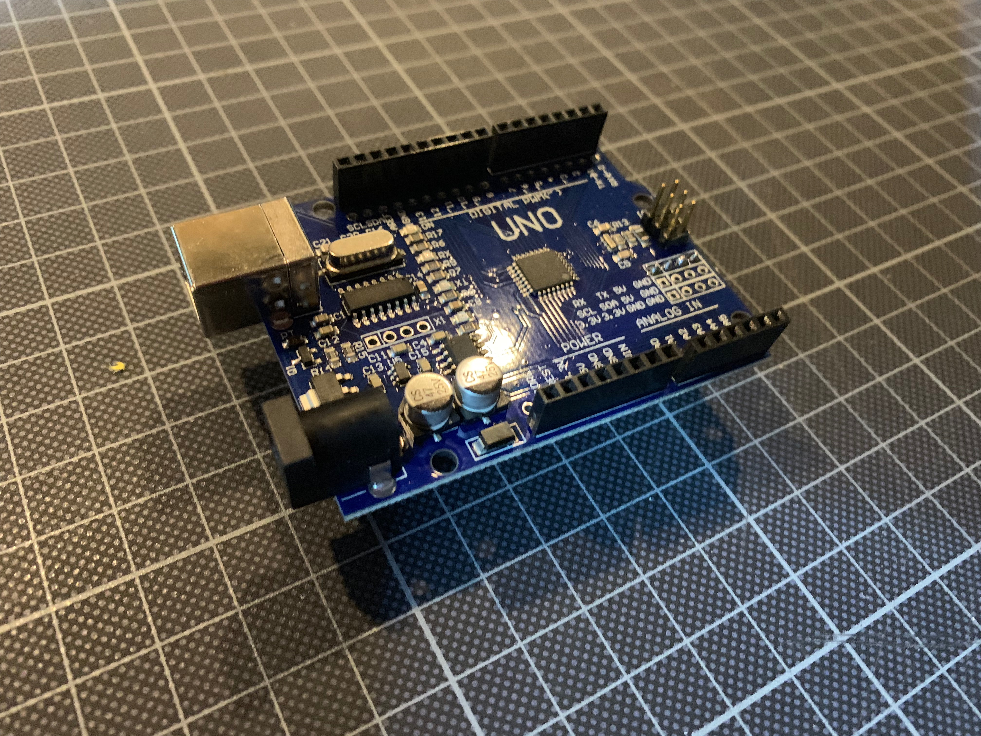
Hardware/Fotos/Arduino UNO.jpg
